Koco-008/SPOT/hardware/images/README.md

# SPOT – Hardware Photos

Photographs of the assembled SPOT prototype. All images show the actual device.

| View | Photo |
| --- | --- |
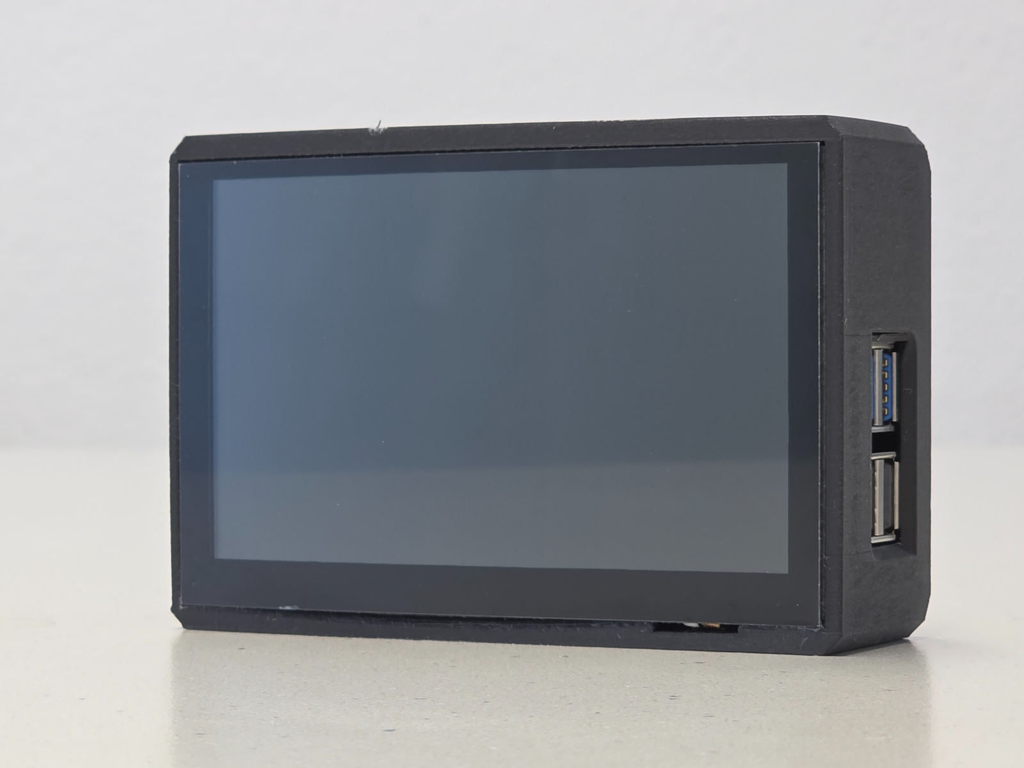
[picture p1: hardware/images/spot-display.jpg]
SPOT touchscreen and enclosure
| Display side |  |
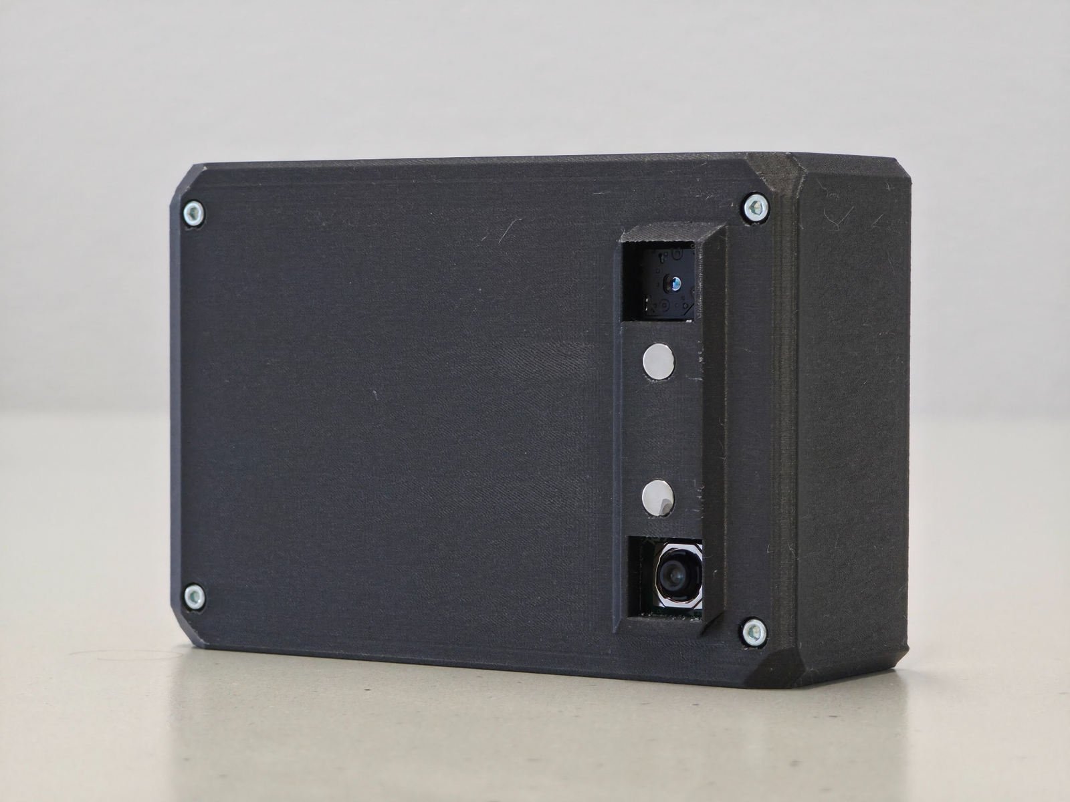
[picture p2: hardware/images/spot-sensors.jpg]
SPOT thermal and RGB camera modules
| Sensor side |  |
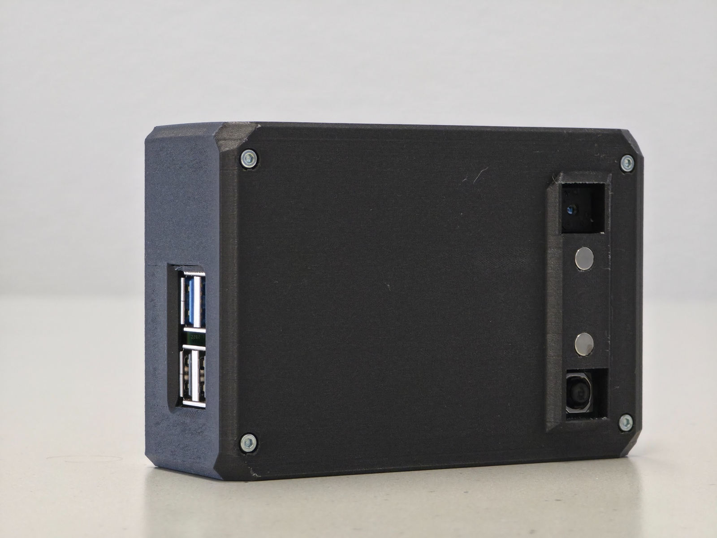
[picture p3: hardware/images/spot-sensors-and-usb.jpg]
Angled view of the camera modules and USB ports
| Sensor side and USB ports |  |
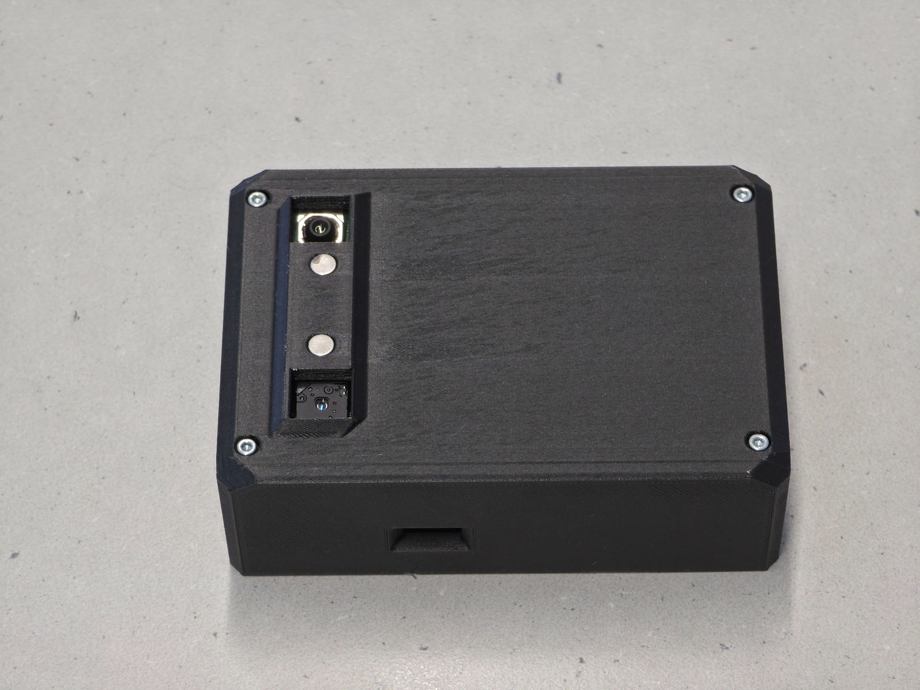
[picture p4: hardware/images/spot-top.jpg]
Top view of the SPOT camera enclosure and sensors
| Top view |  |
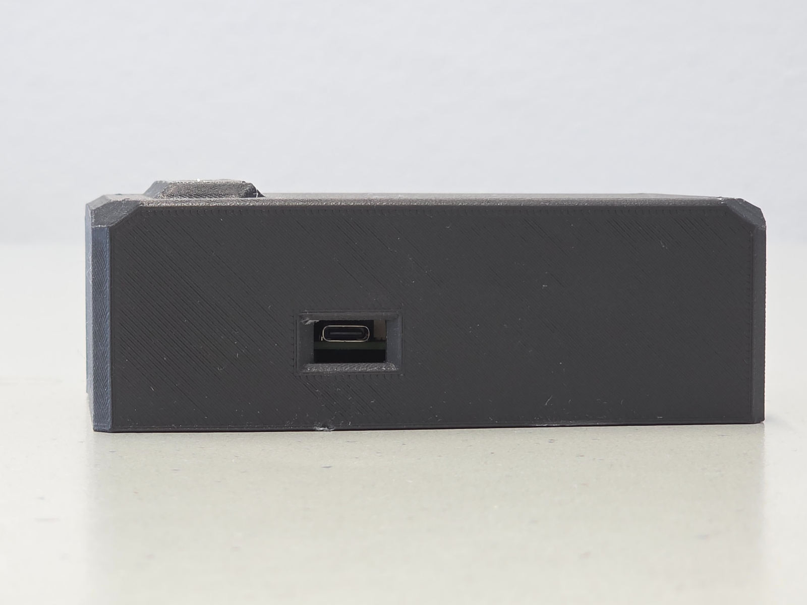
[picture p5: hardware/images/spot-usb-c.jpg]
USB-C power connector in the SPOT enclosure
| USB-C power port |  |
