Koco-008/SPOT/hardware/cad/README.md

# SPOT – CAD Files

STEP models of the SPOT enclosure.

| Part | CAD file |
| --- | --- |
| Main enclosure | [SPOT_Case.step](SPOT_Case.step) |
| Camera cover | [SPOT_Camera_Cover.step](SPOT_Camera_Cover.step) |

Exported from Creo Parametric.
