Koco-008/SPOT/hardware/pcb/README.md

# SPOT Connector PCB

Manufacturing files for the SPOT connector PCB.

[Bill of Materials (BOM)](BOM.md)

| Revision | Gerber archive |
| --- | --- |
| v1.2 | [SPOT_Connector-PCB_v1.2.zip](SPOT_Connector-PCB_v1.2.zip) |

The archive contains Gerber X2 and drill files for ordering on PCB Platforms such as JLCPCB.
Use standard settings when ordering.
