Koco-008/SPOT/BOM.md

# Bill of Materials (BOM)

| Quantity | Part | Recommended SKU |
| --- | --- | --- |
| 1 | Raspberry Pi 5 (at least 4 GB RAM) | SC1111 (4 GB) |
| 1 | Raspberry Pi Active Cooler | SC1148 |
| 1 | Raspberry Pi 27W USB-C Power Supply | SC1152 (white, EU) |
| 1 | microSD card (at least 16 GB) | SDSQQNR-032G-GN6IA (SanDisk High Endurance, 32 GB) |
| 1 | FLIR Lepton 3.5 Radiometric | 500-0771-01 |
| 1 | FLIR Lepton Breakout Board v2 | 250-0577-00 |
| 1 | Raspberry Pi Camera Module 3 Standard 75° | SC0872 |
| 1 | Waveshare 5" DSI LCD 800×480 | 18396 |
| 4 | M2.5 × 14 mm screws | — |
| 4 | 6 × 3 mm neodymium magnets | — |
| 1 | Custom SPOT Connector PCB | — |
| 1 | Custom 3D-printed SPOT case | — |
| 1 | Custom 3D-printed SPOT camera cover | — |
