Koco-008/SPOT/hardware/pcb/BOM.md

# SPOT Connector PCB – Bill of Materials

| Quantity | Part | Recommended SKU |
| --- | ---- | --- |
| 1 | Samtec 2×12 PCB receptacle, 2.54 mm, 24 contacts (P1) | SSW-112-01-F-D |
| 1 | Samtec 2×10 right-angle PCB receptacle, 2.54 mm, 20 contacts (P2) | SSW-110-02-G-D-RA |
| 3 | 33 Ω 0603 resistors (R1, R2, R3) | — |
| 1 | 100 nF / 50 V 0603 capacitor (C2) | — |
| 1 | 10 µF / 25 V 0603 capacitor (C1) | — |
| 8 | Essentra M2 × 4 mm slotted fillister-head screws | 50M020040F004 |
| 4 | Harwin M2 × 4 mm hexagonal brass spacers (4.9 mm A/F) | R20-1000602 |

*Values and connector part numbers are taken from the supplied Altium schematic screenshots. Specific manufacturer SKUs and footprints for the resistors and capacitors are not identified in those screenshots.*
