Koco-008/SPOT/hardware/cad/SPOT_Case.step

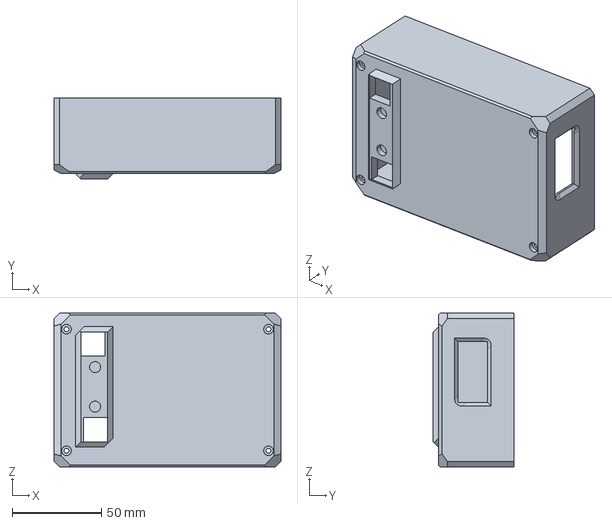
[picture p6: CAD file, 2026-11-10]
hardware/cad/SPOT_Case.step
127.0 x 45.2 x 86.0 mm
