Koco-008/SPOT/hardware/cad/SPOT_Camera_Cover.step

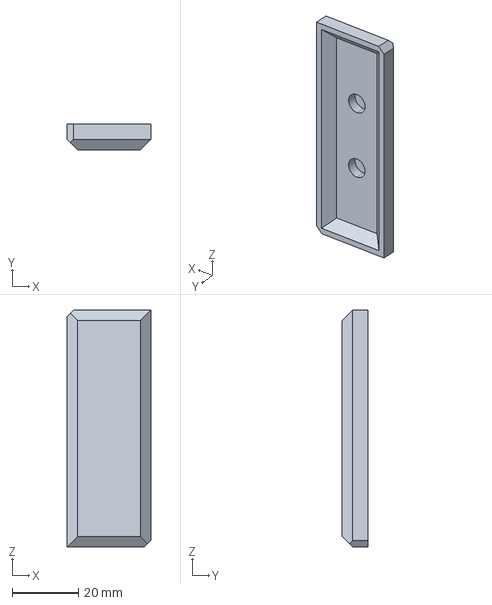
[picture p7: CAD file, 2026-11-10]
hardware/cad/SPOT_Camera_Cover.step
25.4 x 7.80 x 71.8 mm
