Koco-008/SPOT/(commit log)

2026-11-05 docs: publish complete SPOT BMA hardware and software build guide
    [BOM.csv]
2026-11-10 docs: add English SPOT BOM with verified manufacturer part numbers
    [BOM.csv]
2026-11-10 hardware: add SPOT Connector PCB v1.2 Gerber package
2026-11-10 Update README with Gerber archive details and ordering info
    Clarified the contents of the Gerber archive and added ordering instructions.
2026-11-10 docs: add SPOT connector PCB bill of materials from schematic
2026-11-10 hardware: add English-named SPOT enclosure STEP models
    [SPOT_Camera_Cover.step, SPOT_Case.step]
2026-11-10 hardware: add PCB mounting screws and spacers to BOM
2026-11-10 docs: add illustrated SPOT assembly instructions
2026-11-10 docs: convert illustrated assembly guide to English Markdown
2026-11-10 Specify package sizes for resistors and capacitors
    Updated component specifications to include package sizes for resistors and capacitors.
2026-11-11 docs: pin official Raspberry Pi OS image and repair build guide links
2026-11-11 docs: add assembly prerequisites, brass spacers and camera cover magnets
